alexjiao125/capstone408g/Pedestrians.jpg

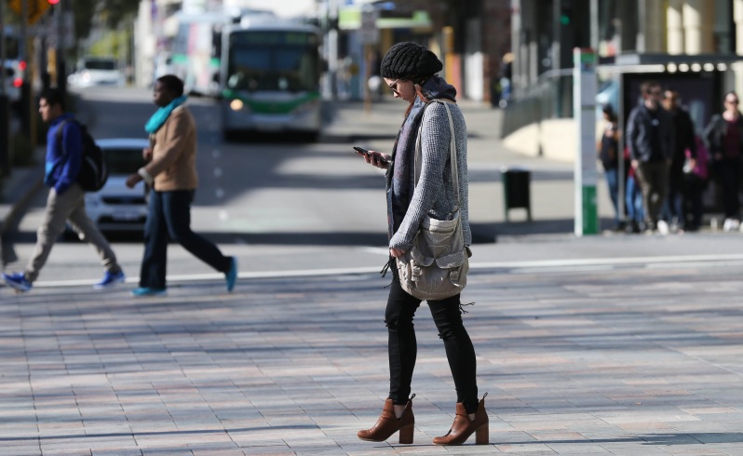
Pedestrians.jpg
