alexjiao125/capstone408g/README.md

# capstone408g
Capstone Project to do Motion Following on Raspberry Pi using OpenCV and Deep Learning
