alexjiao125/capstone408g/Final_Submission/Doc/README.txt

This directory contains all of our documentation and reports

- Final Report: a detailed technical description of every aspect of this project.
- User Manual: describes how to set up the Raspberry Pi OS and Python environments, and how 
  to assemble the case and gimbal mechanism
- Final Presentation: the slide deck we presented to the class on May 14
- Developers Notes: Notes on bugs and program structure.
- Development Plan: A timeline of progress for our project.
