alexjiao125/capstone408g/Final_Submission/3DPrints/base.stl

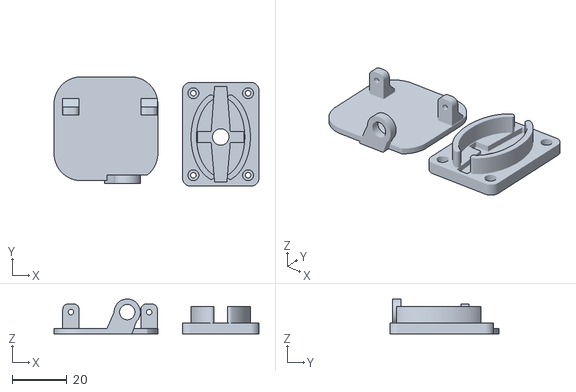
[picture p13: CAD file, 2019-05-19]
Final_Submission/3DPrints/base.stl
75.0 x 40.0 x 12.8
