alexjiao125/capstone408g/Final_Submission/3DPrints/Rasbpi_bottom.stl

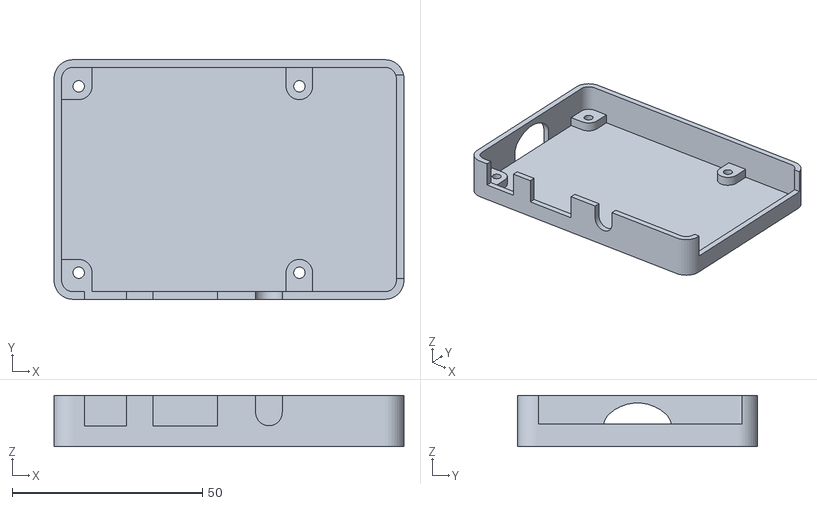
[picture p14: CAD file, 2019-05-19]
Final_Submission/3DPrints/Rasbpi_bottom.stl
92.0 x 63.0 x 13.5
