alexjiao125/capstone408g/Final_Submission/3DPrints/Camera_housing_part1.stl

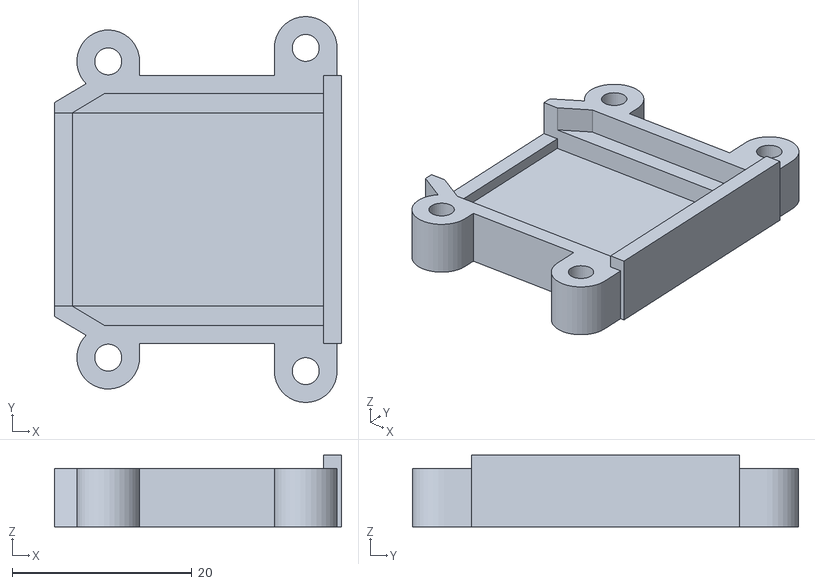
[picture p15: CAD file, 2019-05-19]
Final_Submission/3DPrints/Camera_housing_part1.stl
32.0 x 43.0 x 8.00
