alexjiao125/capstone408g/Final_Submission/3DPrints/HolderL.stl

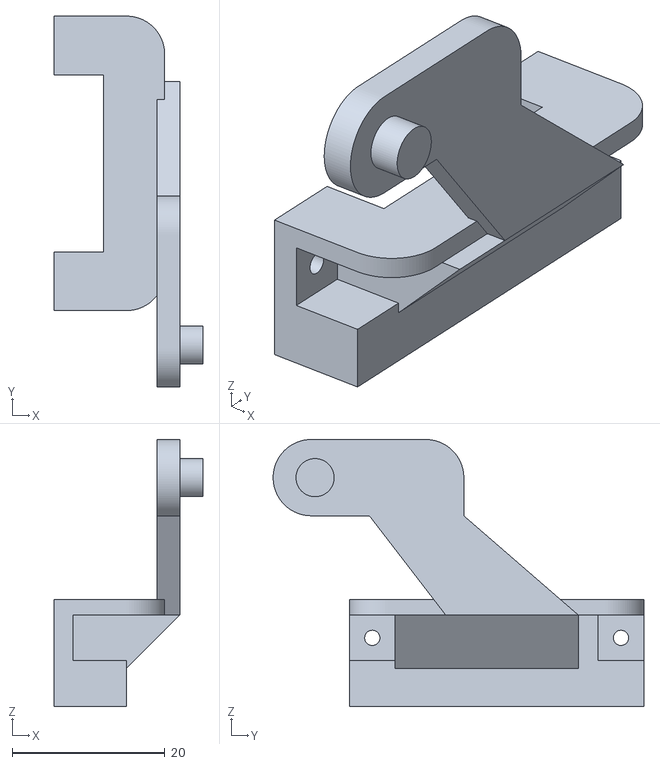
[picture p16: CAD file, 2019-05-19]
Final_Submission/3DPrints/HolderL.stl
19.5 x 48.6 x 35.0
