alexjiao125/capstone408g/Final_Submission/3DPrints/HolderR.stl

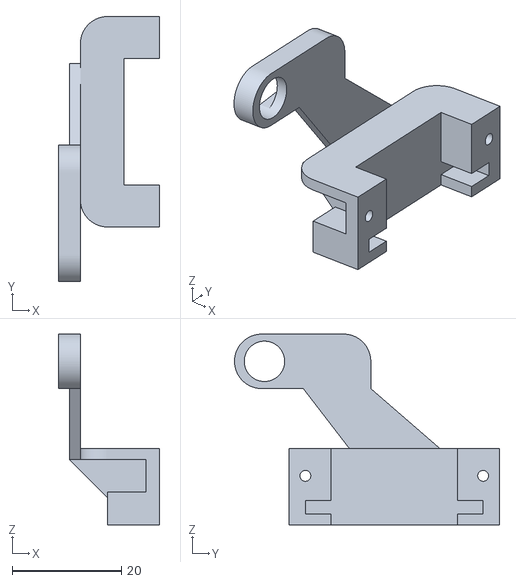
[picture p17: CAD file, 2019-05-19]
Final_Submission/3DPrints/HolderR.stl
18.5 x 48.6 x 35.0
