alexjiao125/capstone408g/Final_Submission/3DPrints/Rasbpi_top.stl

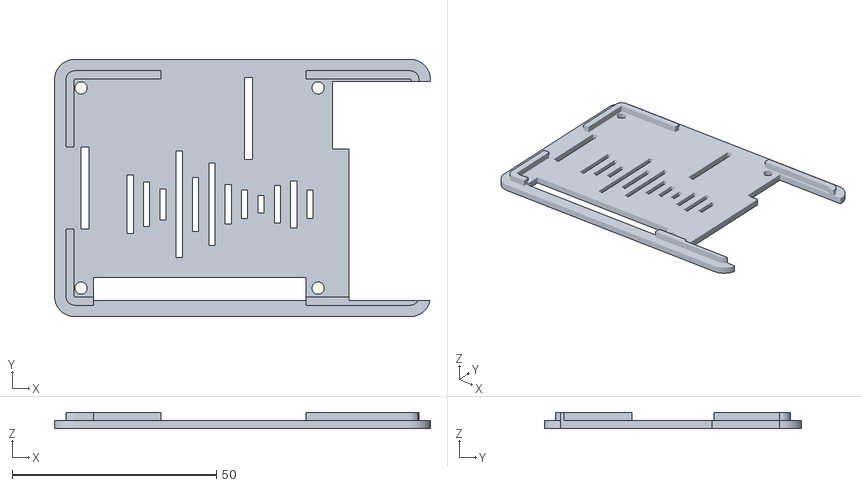
[picture p18: CAD file, 2019-05-19]
Final_Submission/3DPrints/Rasbpi_top.stl
92.0 x 63.0 x 4.00
