alexjiao125/capstone408g/Final_Submission/3DPrints/Camera_housing_part2.stl

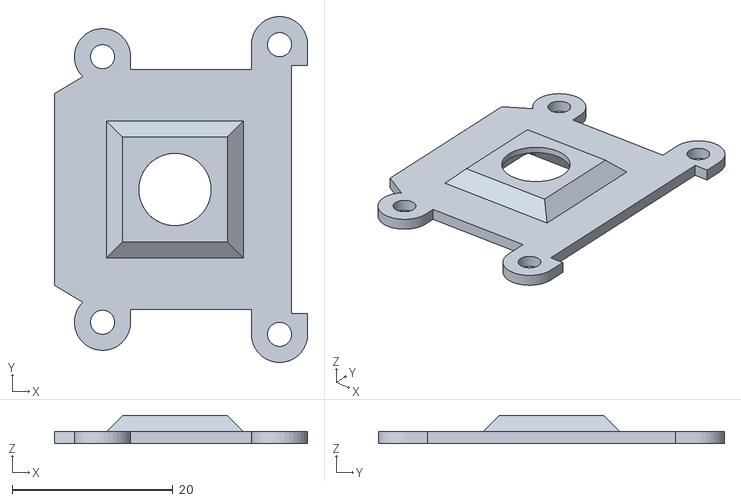
[picture p19: CAD file, 2019-05-19]
Final_Submission/3DPrints/Camera_housing_part2.stl
31.5 x 43.0 x 3.50
