alexjiao125/capstone408g/bgsub2.py

import numpy as np
import cv2
cap = cv2.VideoCapture('People_walking_in_airport.mov')
kernel = cv2.getStructuringElement(cv2.MORPH_ELLIPSE,(3,3))
kernel2 = np.ones((5,5),np.uint8)
fgbg = cv2.bgsegm.createBackgroundSubtractorGMG()
while(1):
    ret, frame = cap.read()
    fgmask = fgbg.apply(frame)
    fgmask = cv2.morphologyEx(fgmask, cv2.MORPH_OPEN, kernel)
    opening = cv2.morphologyEx(fgmask, cv2.MORPH_OPEN, kernel2)
    closing = cv2.morphologyEx(opening, cv2.MORPH_CLOSE, kernel2)
    cv2.imshow('frame',closing)
    k = cv2.waitKey(30) & 0xff
    if k == 27:
        break
cap.release()
cv2.destroyAllWindows()
