alexjiao125/capstone408g/(commit log)

2019-04-23 add servo
2019-05-07 fixed a few bugs in hog_detection.py
    [hog_detection.py]
2019-05-07 added older version of servo control
2019-05-07 added PID to servo
2019-05-07 update gpio_servo with PID
2019-05-07 commented to distinguish servo.py from gpio_servo.py
2019-05-09 made corrections to gpio_servo.py. The module still needs to be tested/integrated. Updated sweep.py to illustrate usage of gpio_servo.py
    [gpio_servo.py, hog_detection.py, sweep.py]
2019-05-10 added fixes to gpio_servo and integrated. py
    [integrated.py]
2019-05-14 most recent changes to integrated.py. Added feature so servo cannot adjust itself more than a set threshold at a given time. Also added ability to reselect a box.
2019-05-19 added 3d print files
    [Camera_housing_part1.stl, Camera_housing_part2.stl, HolderL.stl, HolderR.stl, Rasbpi_bottom.stl, Rasbpi_top.stl, base.stl]
